ECE-445/smart-insole/notebooks/ramseyv2/4/9/aperture.png

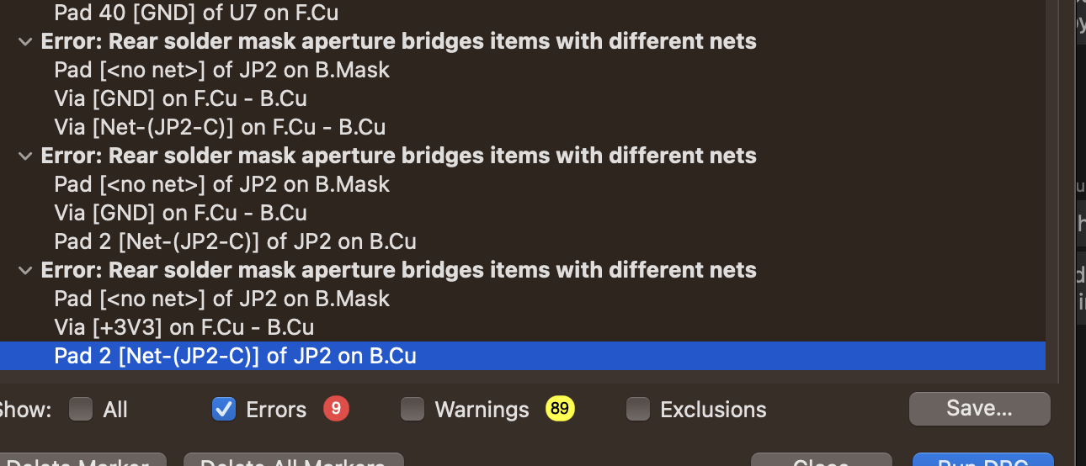
notebooks/ramseyv2/4/9/aperture.png
