ECE-445/smart-insole/notebooks/ramseyv2/software.png

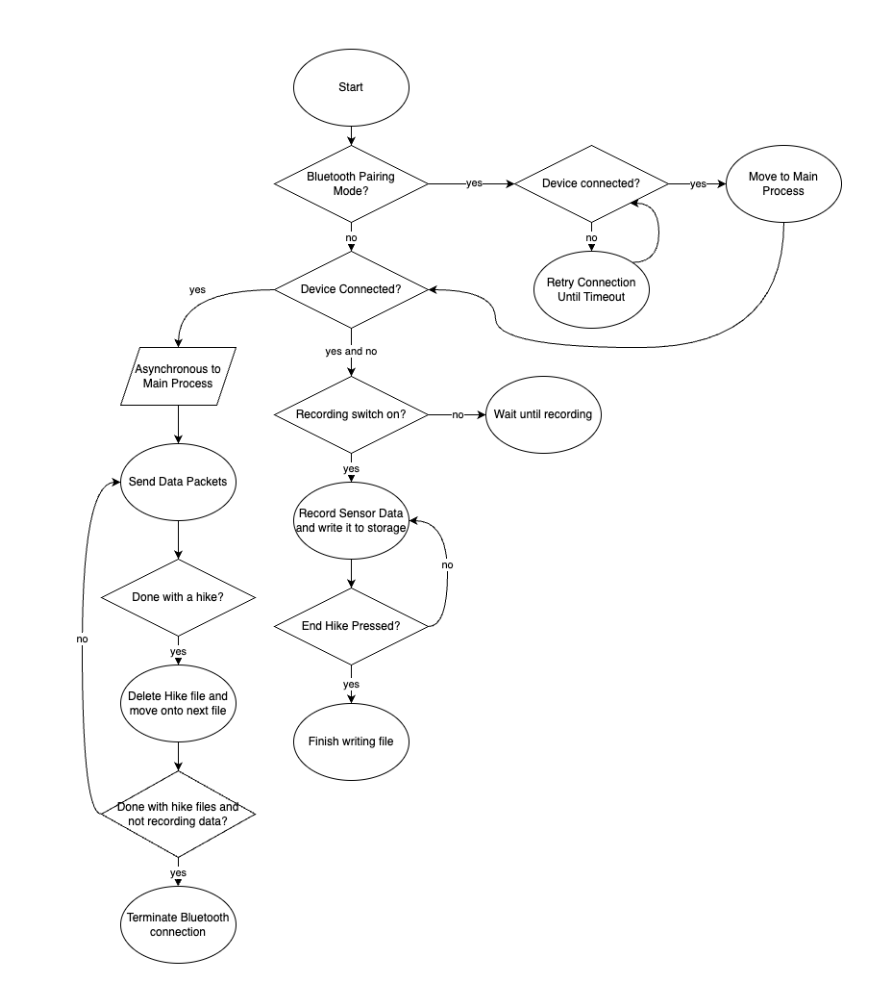
notebooks/ramseyv2/software.png
