ECE-445/smart-insole/boards/SmartInsolePCB/ESP32_S3_MINI_1_N8/ESP32-S3-MINI-1-N8.step

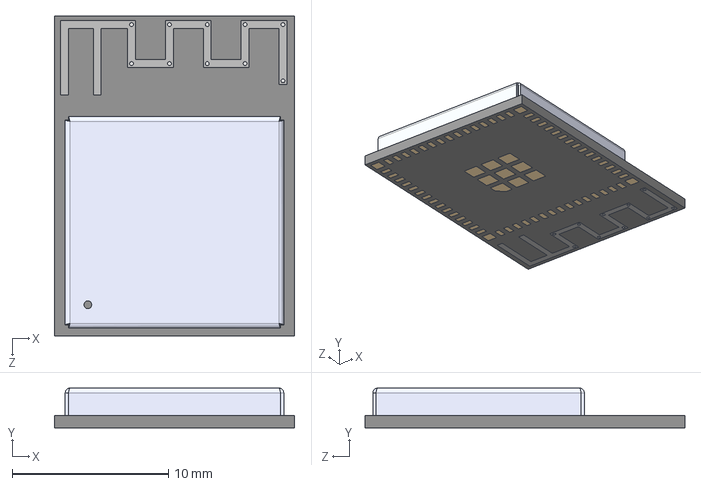
[picture p62: CAD file, 2024-02-29]
boards/SmartInsolePCB/ESP32_S3_MINI_1_N8/ESP32-S3-MINI-1-N8.step
15.4 x 2.55 x 20.5 mm
