ECE-445/smart-insole/boards/SmartInsolePCB/Footprints/ESP32-S3 footprint/ESP32-S3.step

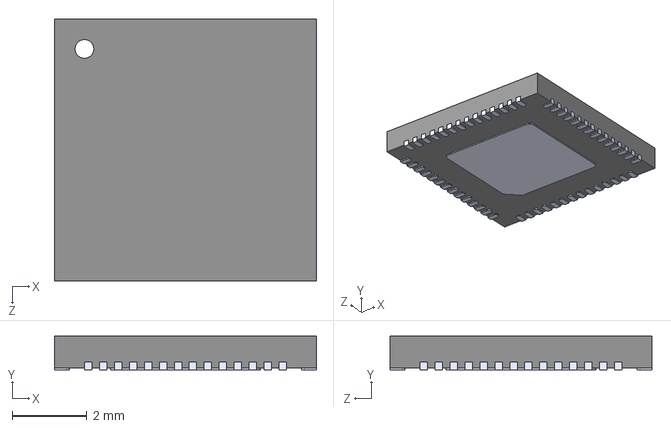
[picture p63: CAD file, 2024-03-01]
boards/SmartInsolePCB/Footprints/ESP32-S3 footprint/ESP32-S3.step
7.00 x 0.9 x 7.00 mm
