ECE-445/smart-insole/boards/SmartInsolePCB/Footprints/PJS008U-3000-0/PJS008U-3000-0/3D/PJS008U-3000-0.stp

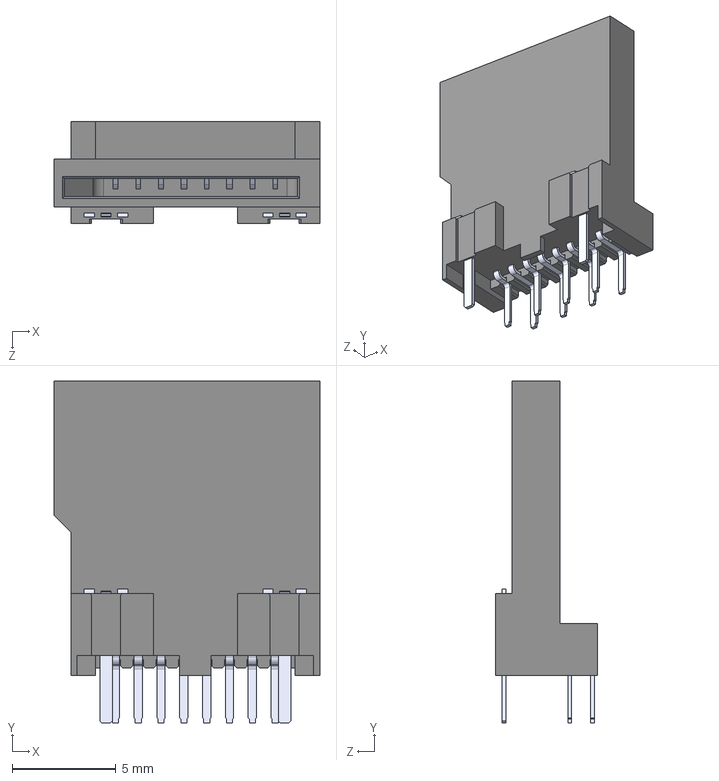
[picture p64: CAD file, 2024-03-05]
boards/SmartInsolePCB/Footprints/PJS008U-3000-0/PJS008U-3000-0/3D/PJS008U-3000-0.stp
12.8 x 16.5 x 4.90 mm
