ECE-445/smart-insole/boards/SmartInsolePCB/LIB_D3V3XA4B10LP-7/3D_MODEL_D3V3XA4B10LP-7.stp

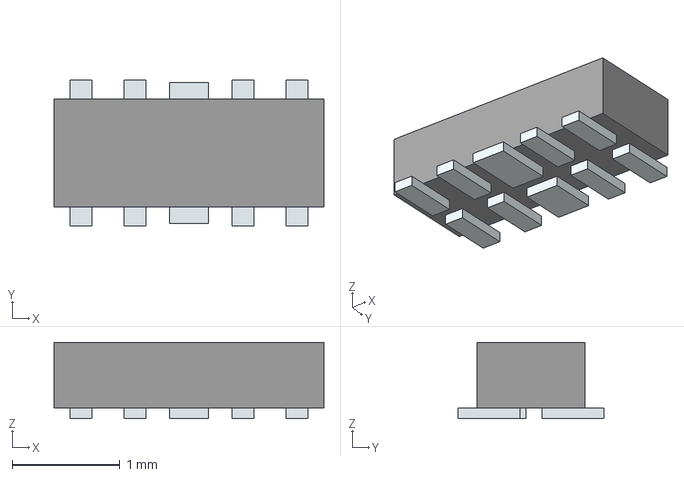
[picture p65: CAD file, 2024-02-29]
boards/SmartInsolePCB/LIB_D3V3XA4B10LP-7/3D_MODEL_D3V3XA4B10LP-7.stp
2.50 x 1.35 x 0.705 mm
Pins
