ECE-445/smart-insole/boards/SmartInsolePCB/PTS810SJK250SMTR LFS/PTS810SJK250SMTR LFS--3DModel-STEP-56544.STEP

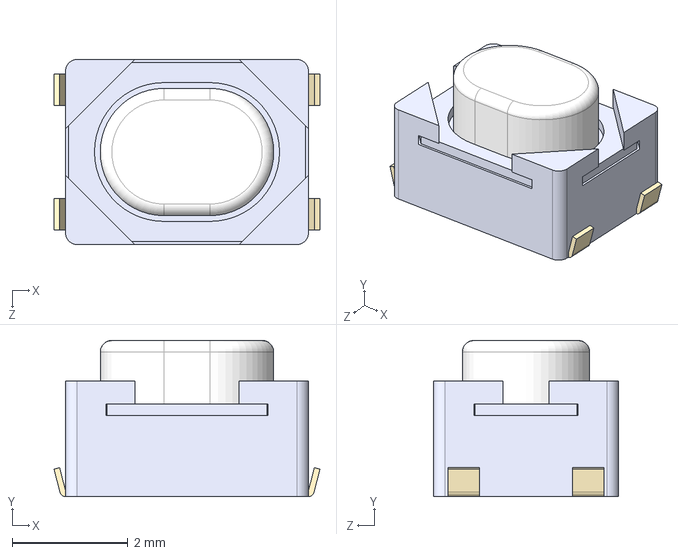
[picture p66: CAD file, 2024-02-29]
boards/SmartInsolePCB/PTS810SJK250SMTR LFS/PTS810SJK250SMTR LFS--3DModel-STEP-56544.STEP
4.60 x 2.70 x 3.20 mm
