ECE-445/smart-insole/boards/SmartInsoleV2/Footprints/MEM2051-00-195-00-A/MEM2051-00-195-00-A.step

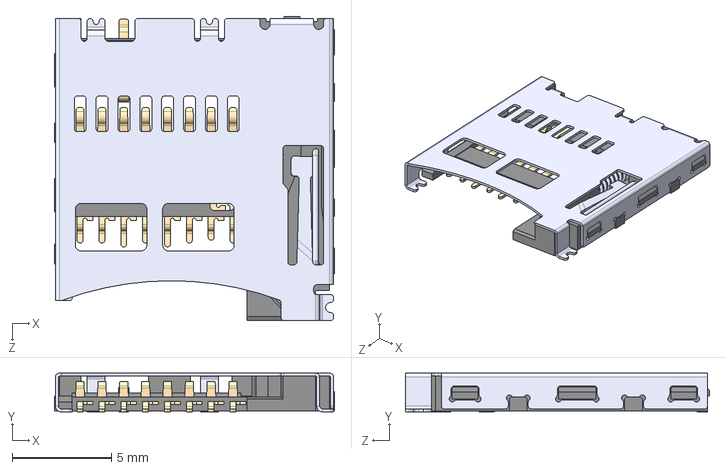
[picture p67: CAD file, 2024-04-05]
boards/SmartInsoleV2/Footprints/MEM2051-00-195-00-A/MEM2051-00-195-00-A.step
14.1 x 1.95 x 15.3 mm
