ECE-445/smart-insole/boards/SmartInsolePCB/Footprints/LIB 78800-0001/78800-0001/3D/78800-0001.stp

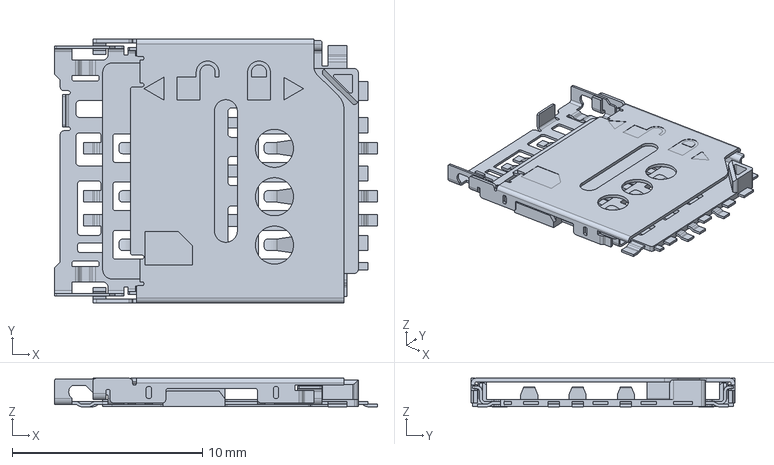
[picture p68: CAD file, 2024-03-05]
boards/SmartInsolePCB/Footprints/LIB 78800-0001/78800-0001/3D/78800-0001.stp
17.0 x 13.8 x 1.50 mm
