ECE-445/smart-insole/(list of files, cad)

Other CAD files:
boards/SmartInsolePCB/Footprints/LIB 78800-0001/78800-0001/Allegro/788000001.psm
boards/SmartInsolePCB/Footprints/LIB 78800-0001/78800-0001/DEHDL/78800_0001/chips/chips.prt
boards/SmartInsolePCB/Footprints/PJS008U-3000-0/PJS008U-3000-0/Allegro/pjs008u30000.psm
boards/SmartInsolePCB/Footprints/PJS008U-3000-0/PJS008U-3000-0/DEHDL/pjs008u_3000_0/chips/chips.prt
