ECE-445/smart-insole/(list of files, drawings)

Other design files:
boards/SmartInsolePCB/Footprints/LIB 78800-0001/78800-0001/Altium/78800-0001.SchLib
boards/SmartInsolePCB/Footprints/LIB 78800-0001/78800-0001/Altium/788000001.PcbLib
boards/SmartInsolePCB/Footprints/PJS008U-3000-0/PJS008U-3000-0/Altium/PJS008U30000.PcbLib
boards/SmartInsolePCB/Footprints/PJS008U-3000-0/PJS008U-3000-0/Altium/PJS008U-3000-0.SchLib
