ECE-445/smart-insole/boards/SmartInsoleV2/esp32_example.kicad_pcb

## KiCad design boards/SmartInsoleV2/esp32_example.kicad_pcb (2024-04-25)

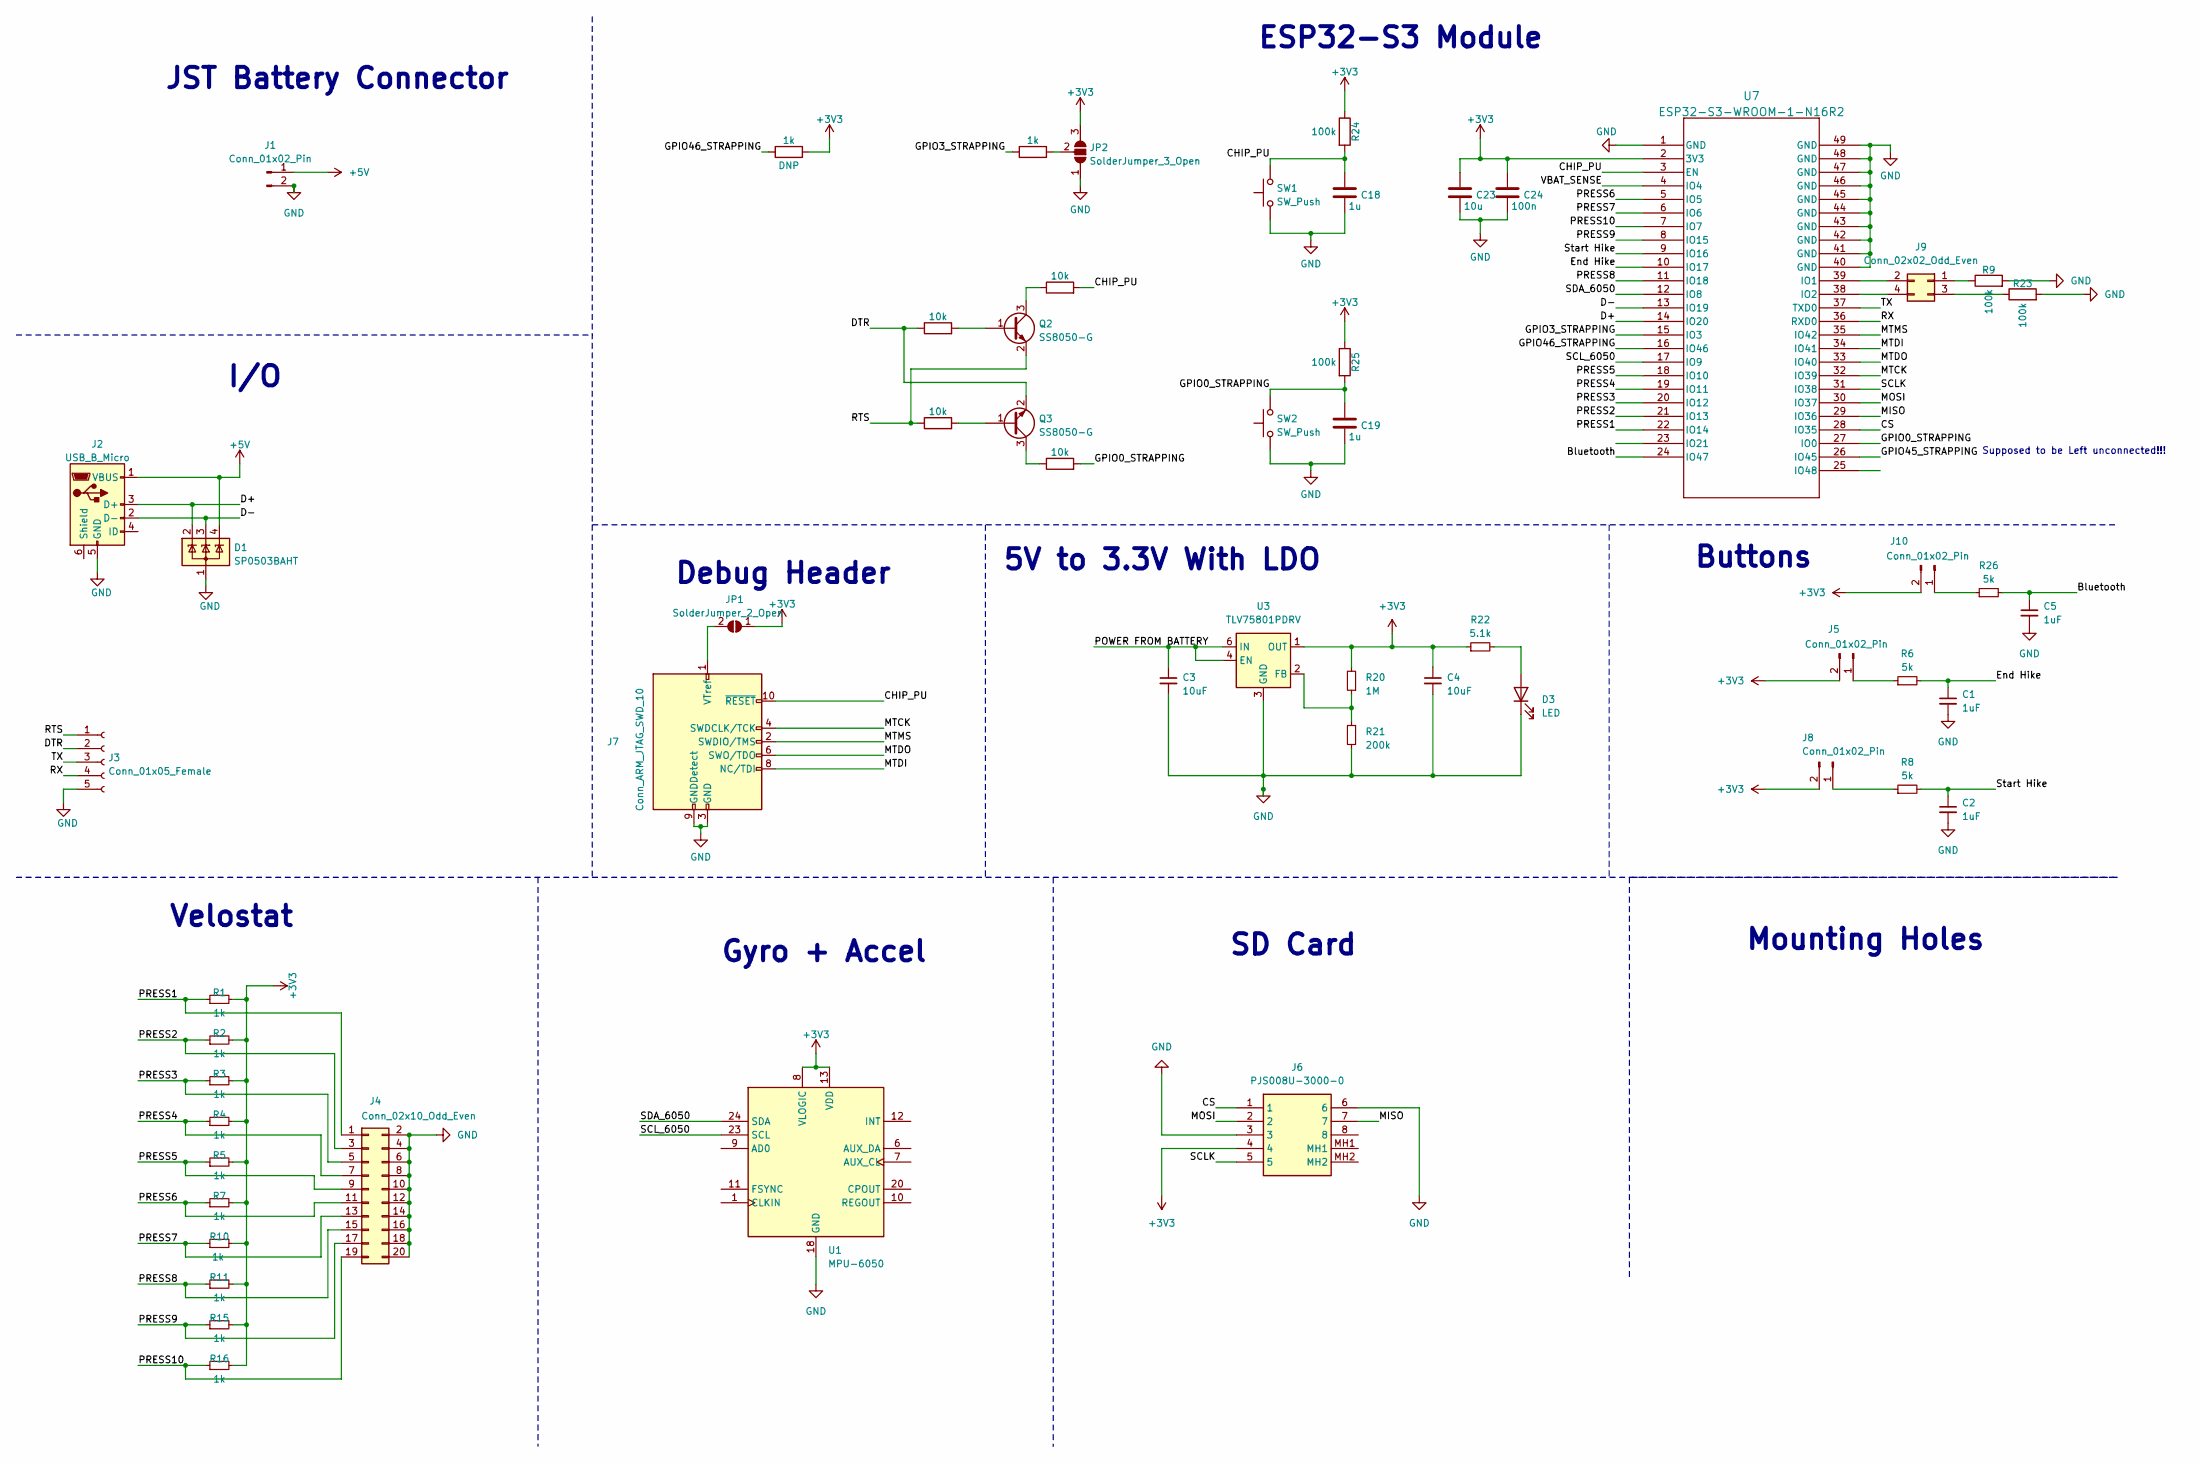
[picture p69: schematic esp32_example.kicad_sch, Smart Insole]

Parts:
C1, C2, C5: 1uF; C_0805_2012Metric
C3, C4: 10uF; C_0805_2012Metric
C18, C19: 1u; C_0805_2012Metric
C23: 10u; C_0805_2012Metric
C24: 100n; C_0805_2012Metric
D1: SP0503BAHT; SOT-143
D3: LED; LED_0805_2012Metric
J1: Conn_01x02_Pin; JST_PH_B2B-PH-K_1x02_P2.00mm_Vertical
J2: USB_B_Micro; USB_Micro-B_Amphenol_10118194_Horizontal
J3: Conn_01x05_Female; PinHeader_1x05_P2.54mm_Vertical
J4: Conn_02x10_Odd_Even; PinHeader_2x10_P2.54mm_Vertical
J5, J8, J10: Conn_01x02_Pin; PinHeader_1x02_P2.54mm_Vertical
J6: PJS008U-3000-0; GCT_MEM2051-00-195-00-A; Mouser Part Number 945-PJS008U-3000-0
J7: Conn_ARM_JTAG_SWD_10; IDC-Header_2x05_P2.54mm_Vertical
J9: Conn_02x02_Odd_Even; PinHeader_2x02_P2.54mm_Vertical
JP1: SolderJumper_2_Open; SolderJumper-2_P1.3mm_Open_TrianglePad1.0x1.5mm
JP2: SolderJumper_3_Open; SolderJumper-3_P2.0mm_Open_TrianglePad1.0x1.5mm
Q2, Q3: SS8050-G; SOT-23
R1, R2, R3, R4, R5, R7, R10, R11, R12, R15, R16, R17: 1k; R_0805_2012Metric
R6, R8, R26: 5k; R_0805_2012Metric
R9, R23, R24, R25: 100k; R_0805_2012Metric
R13, R14, R18, R19: 10k; R_0805_2012Metric
R20: 1M; R_0603_1608Metric
R21: 200k; R_0603_1608Metric
R22: 5.1k; R_0603_1608Metric
SW1, SW2: SW_Push; SW_SPST_B3S-1000
U1: MPU-6050; InvenSense_QFN-24_4x4mm_P0.5mm
U3: TLV75801PDRV; WSON-6-1EP_2x2mm_P0.65mm_EP1x1.6mm
U7: ESP32-S3-WROOM-1-N16R2; ESP32-S3-WROOM-1_EXP

Connections:
+3V3: C4.1, C23.1, C24.1, J5.2, J6.4, J8.2, J10.2, JP1.1 (A), JP2.3 (B), R1.2, R2.2, R3.2, R4.2, R5.2, R7.2, R10.2, R11.2, R12.2, R15.2, R16.2, R20.2, R22.1, R24.1, R25.1, U1.8 (VLOGIC), U1.13 (VDD), U3.1 (OUT), U7.2 (3V3)
+5V: D1.4 (K), J1.1, J2.1 (VBUS)
/Bluetooth: C5.1, R26.2, U7.24 (IO47)
/CHIP_PU: C18.1, J7.10 (~RESET), R18.2, R24.2, SW1.2, U7.3 (EN)
/CS: J6.1, U7.28 (IO35)
/D+: D1.2 (K), J2.3 (D+), U7.14 (IO20)
/D-: D1.3 (K), J2.2 (D-), U7.13 (IO19)
/DTR: J3.2, Q3.2 (E), R13.1
/End Hike: C1.1, R6.2, U7.10 (IO17)
/GPIO0_STRAPPING: C19.1, R19.2, R25.2, SW2.2, U7.27 (IO0)
/GPIO3_STRAPPING: R17.1, U7.15 (IO3)
/GPIO45_STRAPPING: U7.26 (IO45)
/GPIO46_STRAPPING: R12.1, U7.16 (IO46)
/MISO: J6.7, U7.29 (IO36)
/MOSI: J6.2, U7.30 (IO37)
/MTCK: J7.4 (SWDCLK/TCK), U7.32 (IO39)
/MTDI: J7.8 (NC/TDI), U7.34 (IO41)
/MTDO: J7.6 (SWO/TDO), U7.33 (IO40)
/MTMS: J7.2 (SWDIO/TMS), U7.35 (IO42)
/POWER FROM BATTERY: C3.1, U3.4 (EN), U3.6 (IN)
/PRESS1: J4.1, R1.1, U7.22 (IO14)
/PRESS2: J4.3, R2.1, U7.21 (IO13)
/PRESS3: J4.5, R3.1, U7.20 (IO12)
/PRESS4: J4.7, R4.1, U7.19 (IO11)
/PRESS5: J4.9, R5.1, U7.18 (IO10)
/PRESS6: J4.11, R7.1, U7.5 (IO5)
/PRESS7: J4.13, R10.1, U7.6 (IO6)
/PRESS8: J4.15, R11.1, U7.11 (IO18)
/PRESS9: J4.17, R15.1, U7.8 (IO15)
/PRESS10: J4.19, R16.1, U7.7 (IO7)
/RTS: J3.1, Q2.2 (E), R14.1
/RX: J3.4, U7.36 (RXD0)
/SCLK: J6.5, U7.31 (IO38)
/SCL_6050: U1.23 (SCL), U7.17 (IO9)
/SDA_6050: U1.24 (SDA), U7.12 (IO8)
/Start Hike: C2.1, R8.2, U7.9 (IO16)
/TX: J3.3, U7.37 (TXD0)
/VBAT_SENSE: U7.4 (IO4)
GND: C1.2, C2.2, C3.2, C4.2, C5.2, C18.2, C19.2, C23.2, C24.2, D1.1 (A), D3.1 (K), J1.2, J2.5 (GND), J3.5, J4.2, J4.4, J4.6, J4.8, J4.10, J4.12, J4.14, J4.16, J4.18, J4.20, J6.3, J6.6, J7.3 (GND), J7.5 (GND), J7.9 (GNDDetect), JP2.1 (A), R9.2, R21.1, R23.2, SW1.1, SW2.1, U1.18 (GND), U3.3 (GND), U3.7 (GND), U7.1 (GND), U7.40 (GND), U7.41 (GND), U7.42 (GND), U7.43 (GND), U7.44 (GND), U7.45 (GND), U7.46 (GND), U7.47 (GND), U7.48 (GND), U7.49 (GND)
unnamed: D3.2 (A), R22.2
unnamed: J5.1, R6.1
unnamed: J7.1 (VTref), JP1.2 (B)
unnamed: J8.1, R8.1
unnamed: J9.1, R9.1
unnamed: J9.2, U7.39 (IO1)
unnamed: J9.3, R23.1
unnamed: J9.4, U7.38 (IO2)
unnamed: J10.1, R26.1
unnamed: JP2.2 (C), R17.2
unnamed: Q2.1 (B), R13.2
unnamed: Q2.3 (C), R18.1
unnamed: Q3.1 (B), R14.2
unnamed: Q3.3 (C), R19.1
unnamed: R20.1, R21.2, U3.2 (FB)

Notes on the sheet:
JST Battery Connector
Buttons
SD Card
Velostat
ESP32-S3 Module
Gyro + Accel
Debug Header
Supposed to be Left unconnected!!!
Mounting Holes
5V to 3.3V With LDO
I/O

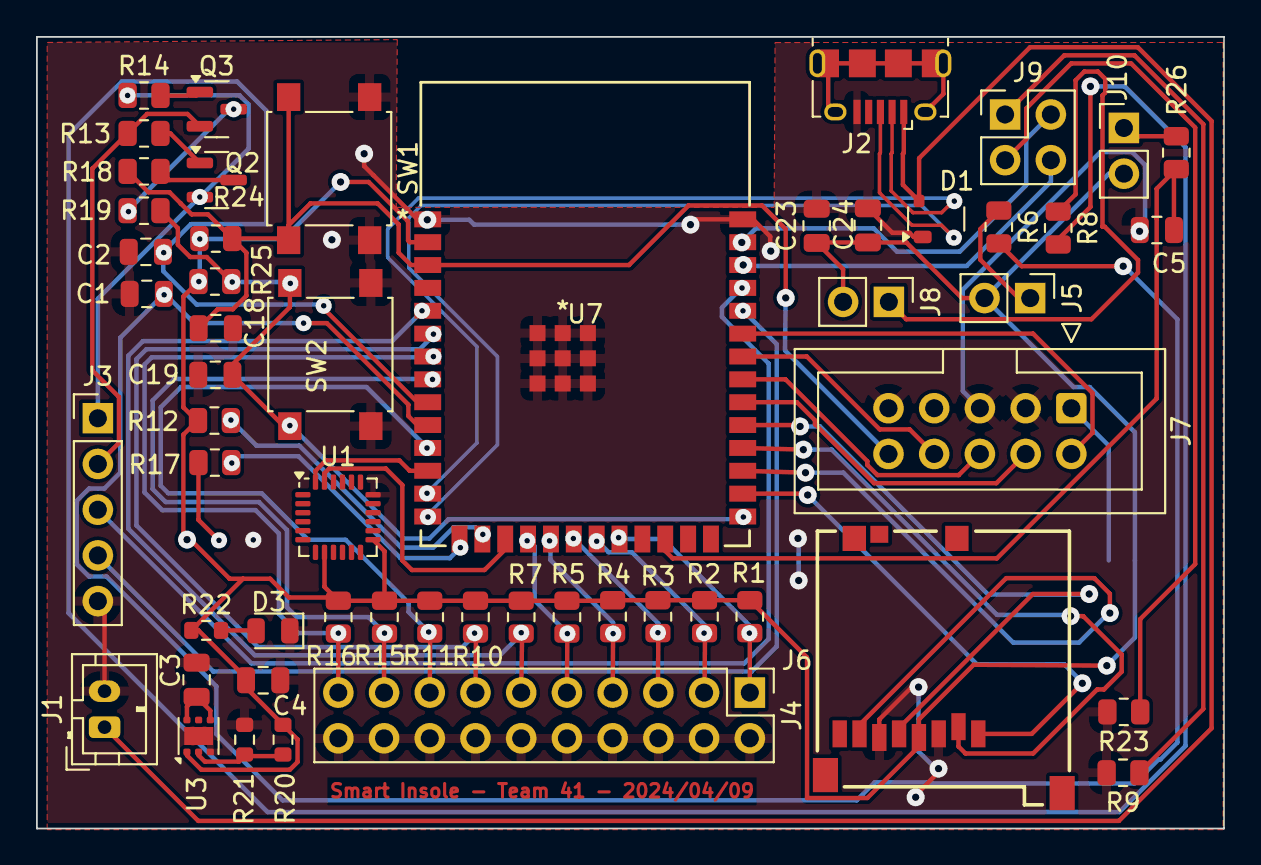
[picture p70: board esp32_example.kicad_pcb from above]

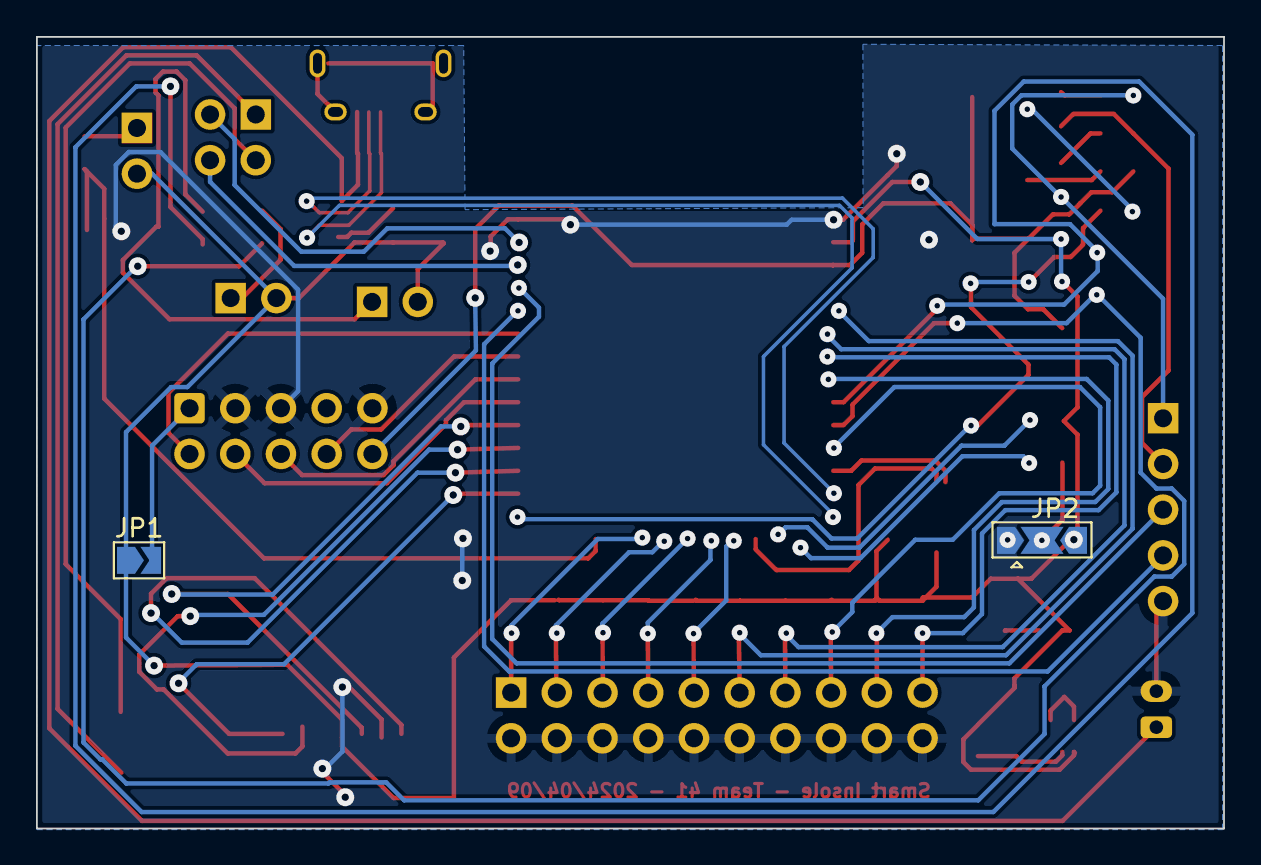
[picture p71: board esp32_example.kicad_pcb from below]

Board: 2 copper layers, 65.9 x 44.0 mm, 56 parts (2 on the bottom side), 52 nets.
