ECE-445/smart-insole/boards/SmartInsolePCB/DesignESP32PCB.kicad_pcb

## KiCad design boards/SmartInsolePCB/DesignESP32PCB.kicad_pcb (2024-03-19)

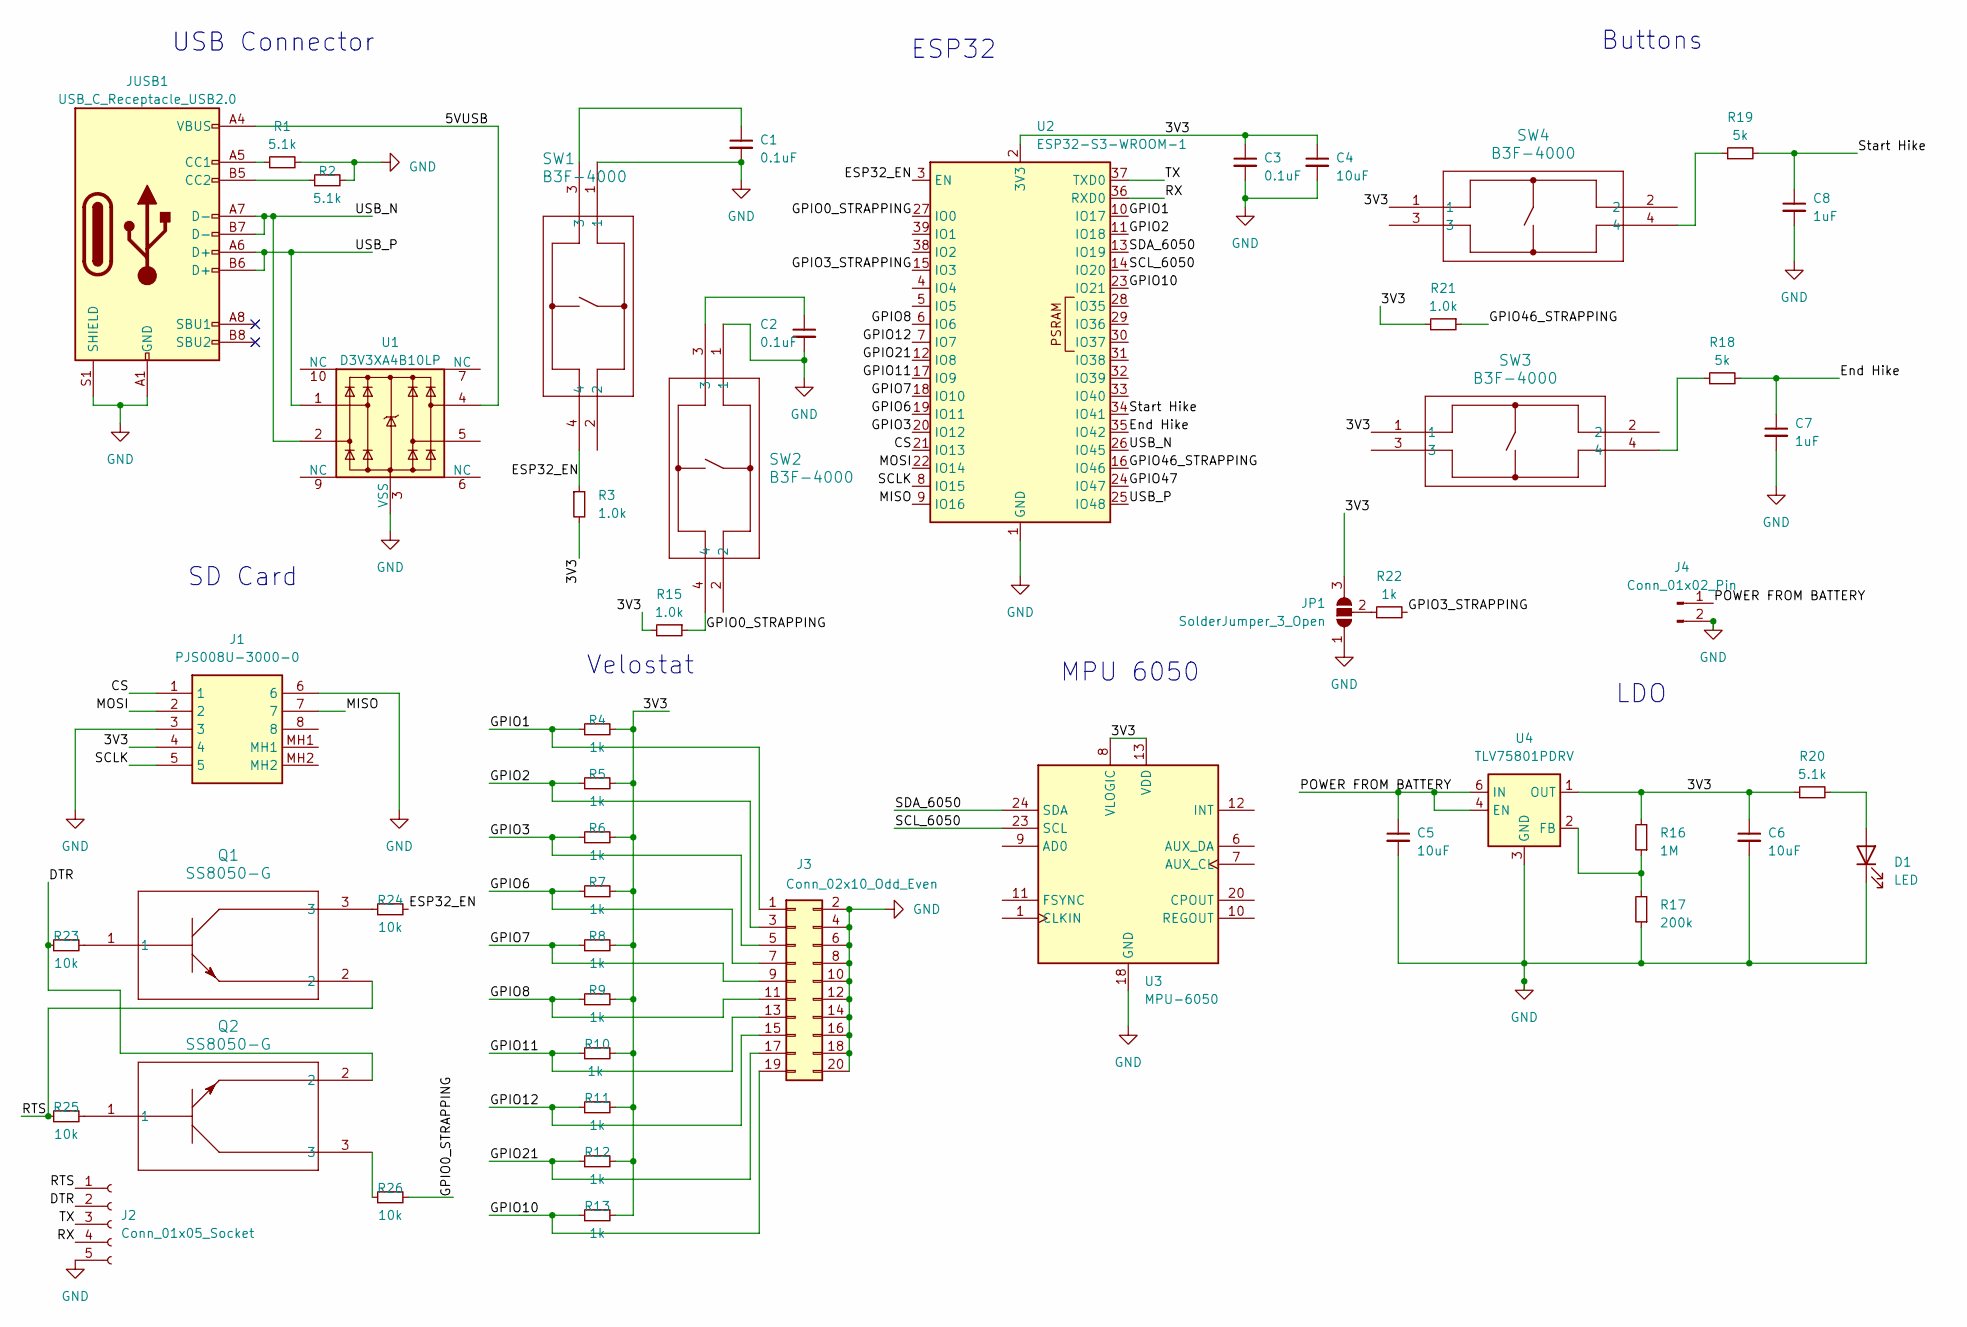
[picture p72: schematic DesignESP32PCB.kicad_sch, Smart Insole PCB Design]

Parts:
C1, C2, C3: 0.1uF; C_0603_1608Metric
C4, C5, C6: 10uF; C_0603_1608Metric
C7, C8: 1uF; C_0603_1608Metric
D1: LED; LED_0603_1608Metric
J1: PJS008U-3000-0; PJS008U30000; Mouser Part Number 945-PJS008U-3000-0
J2: Conn_01x05_Socket; PinHeader_1x05_P2.54mm_Vertical
J3: Conn_02x10_Odd_Even; PinHeader_2x10_P2.54mm_Vertical
J4: Conn_01x02_Pin; JST_PH_B2B-PH-K_1x02_P2.00mm_Vertical
JP1: SolderJumper_3_Open; SolderJumper-3_P1.3mm_Open_RoundedPad1.0x1.5mm
JUSB1: USB_C_Receptacle_USB2.0; USB_C_Receptacle_GCT_USB4105-xx-A_16P_TopMnt_Horizontal
Q1, Q2: SS8050-G; TRAN_SS8050-G_CIP
R1, R2, R20: 5.1k; R_0603_1608Metric
R3, R15, R21: 1.0k; R_0603_1608Metric
R4, R5, R6, R7, R8, R9, R10, R11, R12, R13, R22: 1k; R_0603_1608Metric
R16: 1M; R_0603_1608Metric
R17: 200k; R_0603_1608Metric
R18, R19: 5k; R_0603_1608Metric
R23, R24, R25, R26: 10k; R_0603_1608Metric
SW1, SW2, SW3, SW4: B3F-4000; SW_B3F-4000_OMR
U1: D3V3XA4B10LP; Diodes_UDFN-10_1.0x2.5mm_P0.5mm
U2: ESP32-S3-WROOM-1
U3: MPU-6050; InvenSense_QFN-24_4x4mm_P0.5mm
U4: TLV75801PDRV; WSON-6-1EP_2x2mm_P0.65mm_EP1x1.6mm

Connections:
/3V3: C3.1, C4.1, C6.1, J1.4, JP1.3 (B), R3.2, R4.2, R5.2, R6.2, R7.2, R8.2, R9.2, R10.2, R11.2, R12.2, R13.2, R15.2, R16.2, R20.1, R21.2, SW3.1, SW4.1, U2.2 (3V3), U3.8 (VLOGIC), U3.13 (VDD), U4.1 (OUT)
/5VUSB: JUSB1.A4 (VBUS), JUSB1.A9 (VBUS), JUSB1.B4 (VBUS), JUSB1.B9 (VBUS), U1.4
/CS: J1.1, U2.21 (IO13)
/DTR: J2.2, Q2.2, R23.1
/ESP32_EN: R3.1, R24.2, SW1.4, U2.3 (EN)
/End Hike: C7.1, R18.2, U2.35 (IO42)
/GPIO0_STRAPPING: R15.1, R26.2, SW2.4, U2.27 (IO0)
/GPIO1: J3.1, R4.1, U2.10 (IO17)
/GPIO2: J3.3, R5.1, U2.11 (IO18)
/GPIO3: J3.5, R6.1, U2.20 (IO12)
/GPIO3_STRAPPING: R22.2, U2.15 (IO3)
/GPIO6: J3.7, R7.1, U2.19 (IO11)
/GPIO7: J3.9, R8.1, U2.18 (IO10)
/GPIO8: J3.11, R9.1, U2.6 (IO6)
/GPIO10: J3.19, R13.1, U2.23 (IO21)
/GPIO11: J3.13, R10.1, U2.17 (IO9)
/GPIO12: J3.15, R11.1, U2.7 (IO7)
/GPIO21: J3.17, R12.1, U2.12 (IO8)
/GPIO46_STRAPPING: R21.1, U2.16 (IO46)
/GPIO47: U2.24 (IO47)
/MISO: J1.7, U2.9 (IO16)
/MOSI: J1.2, U2.22 (IO14)
/POWER FROM BATTERY: C5.1, J4.1, U4.4 (EN), U4.6 (IN)
/RTS: J2.1, Q1.2, R25.1
/RX: J2.4, U2.36 (RXD0)
/SCLK: J1.5, U2.8 (IO15)
/SCL_6050: U2.14 (IO20), U3.23 (SCL)
/SDA_6050: U2.13 (IO19), U3.24 (SDA)
/Start Hike: C8.1, R19.2, U2.34 (IO41)
/TX: J2.3, U2.37 (TXD0)
/USB_N: JUSB1.A7 (D-), JUSB1.B7 (D-), U1.2, U2.26 (IO45)
/USB_P: JUSB1.A6 (D+), JUSB1.B6 (D+), U1.1, U2.25 (IO48)
GND: C1.2, C2.2, C3.2, C4.2, C5.2, C6.2, C7.2, C8.2, D1.1 (K), J1.3, J1.6, J2.5, J3.2, J3.4, J3.6, J3.8, J3.10, J3.12, J3.14, J3.16, J3.18, J3.20, J4.2, JP1.1 (A), JUSB1.A1 (GND), JUSB1.A12 (GND), JUSB1.B1 (GND), JUSB1.B12 (GND), JUSB1.S1 (SHIELD), R1.2, R2.2, R17.1, SW1.1, SW2.1, U1.3 (VSS), U1.8 (VSS), U2.1 (GND), U2.40 (GND), U2.41 (GND), U3.18 (GND), U4.3 (GND), U4.7 (GND)
unnamed: C1.1, SW1.3
unnamed: C2.1, SW2.3
unnamed: D1.2 (A), R20.2
unnamed: JP1.2 (C), R22.1
unnamed: JUSB1.A5 (CC1), R1.1
unnamed: JUSB1.B5 (CC2), R2.1
unnamed: Q1.1, R23.2
unnamed: Q1.3, R24.1
unnamed: Q2.1, R25.2
unnamed: Q2.3, R26.1
unnamed: R18.1, SW3.4
unnamed: R19.1, SW4.4
unnamed: R16.1, R17.2, U4.2 (FB)

Notes on the sheet:
MPU 6050
ESP32
SD Card
USB Connector
LDO
Buttons
Velostat

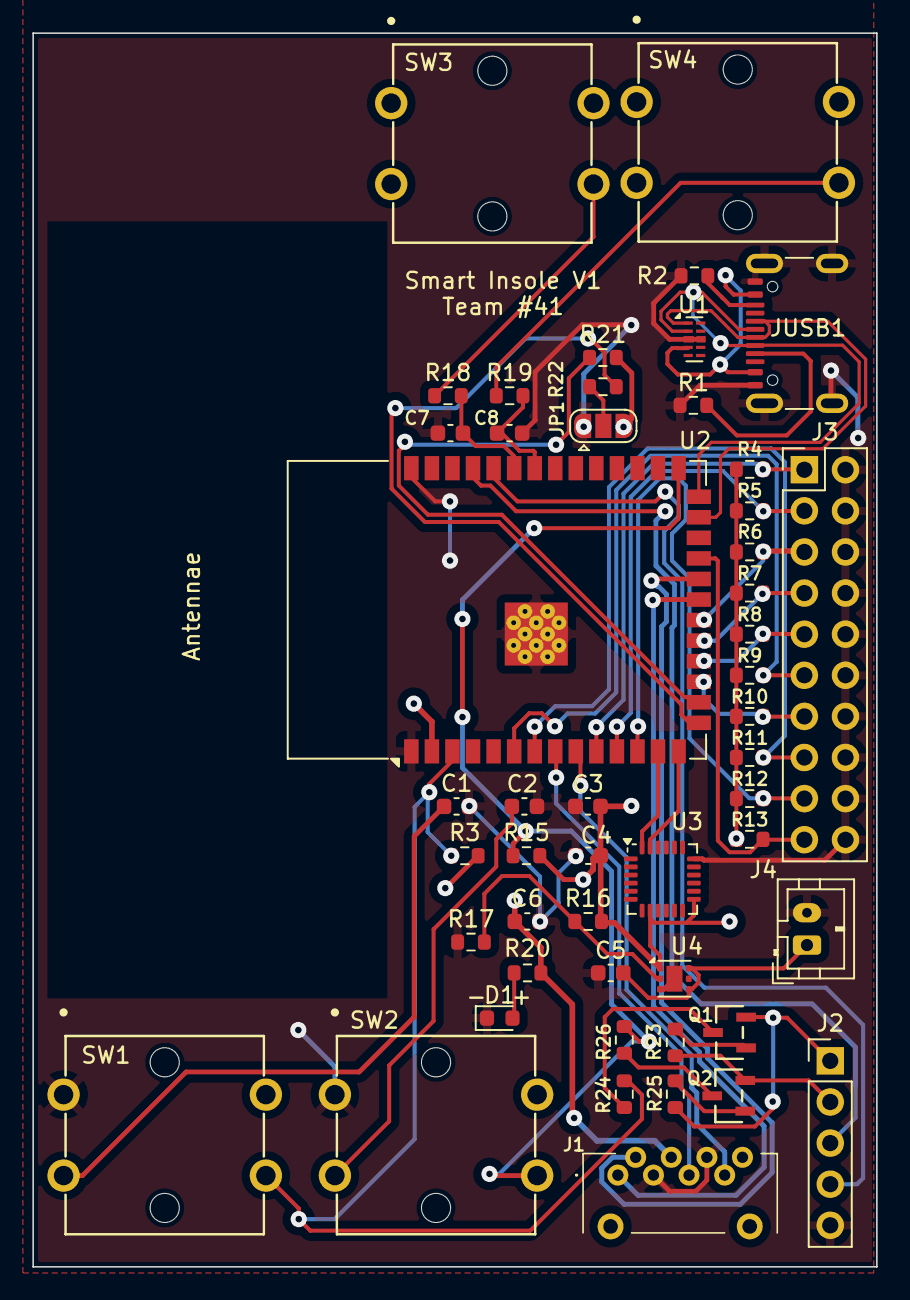
[picture p73: board DesignESP32PCB.kicad_pcb from above]

Board: 2 copper layers, 52.1 x 76.2 mm, 50 parts (0 on the bottom side), 45 nets.
