ECE-445/smart-insole/(commit log)

2024-02-29 Project With basic layout
    [3D_MODEL_D3V3XA4B10LP-7.stp, DesignESP32PCB.kicad_sch, ESP32-S3-MINI-1-N8.step, PTS810SJK250SMTR LFS--3DModel-STEP-56544.STEP]
2024-03-01 added 6050, added footprints
    [DesignESP32PCB.kicad_sch, ESP32-S3.step]
2024-03-01 added SD card Pin headers
    [DesignESP32PCB.kicad_sch]
2024-03-01 replaced ESP32 symbol
    [DesignESP32PCB.kicad_sch]
2024-03-01 PCB design
    [DesignESP32PCB.kicad_pcb]
2024-03-04 debounced buttons and connected pins
    [DesignESP32PCB.kicad_sch]
2024-03-05 finished schematic
    [78800-0001.SchLib, 78800-0001.stp, 788000001.PcbLib, 788000001.psm, DesignESP32PCB.kicad_pcb, DesignESP32PCB.kicad_sch, EDI2CAP.CFG, PJS008U-3000-0.SchLib]
2024-03-05 finished all PCB connections
    [DesignESP32PCB.kicad_pcb, DesignESP32PCB.kicad_sch]
2024-03-05 finished PCB second push just in case
2024-03-05 changed GPIO
    [DesignESP32PCB.kicad_sch]
2024-03-05 down from 200 to 43 errors
    [DesignESP32PCB.kicad_pcb]
2024-03-06 schematic and pcb updates
    [DesignESP32PCB.kicad_pcb, DesignESP32PCB.kicad_sch]
2024-03-18 put extra comp on board
    [DesignESP32PCB.kicad_pcb]
2024-03-18 down to 56
    [DesignESP32PCB.kicad_pcb]
2024-03-18 2 missing connections and 16 erros
    [DesignESP32PCB.kicad_pcb]
2024-03-19 saved work
    [DesignESP32PCB.kicad_pcb]
2024-03-19 added footprint
    [DesignESP32PCB.kicad_sch]
2024-03-19 routed all connections
    [DesignESP32PCB.kicad_pcb, DesignESP32PCB.kicad_sch]
2024-03-19 Passed checks and gerber file created
    [DesignESP32PCB-B_Cu.gbl, DesignESP32PCB-B_Mask.gbs, DesignESP32PCB-B_Paste.gbp, DesignESP32PCB-B_Silkscreen.gbo, DesignESP32PCB-Edge_Cuts.gm1, DesignESP32PCB-F_Cu.gtl, DesignESP32PCB-F_Mask.gts, DesignESP32PCB-F_Paste.gtp]
2024-03-19 quick changes
    [DesignESP32PCB.kicad_pcb]
2024-03-31 added initial heatmap
2024-04-01 updated heatmap
2024-04-04 board V2
    [esp32_example-B_Cu.gbl, esp32_example-B_Mask.gbs, esp32_example-B_Paste.gbp, esp32_example-B_Silkscreen.gbo, esp32_example-Edge_Cuts.gm1, esp32_example-F_Cu.gtl, esp32_example-F_Mask.gts, esp32_example-F_Paste.gtp]
2024-04-04 a little progress
    [esp32_example.kicad_pcb]
2024-04-05 Most of routing done
    [MEM2051-00-195-00-A.step, esp32_example.kicad_pcb, esp32_example.kicad_sch]
2024-04-06 added changes but not finished
    [esp32_example.kicad_pcb, esp32_example.kicad_sch]
2024-04-09 re made board
    [esp32_example.kicad_pcb, esp32_example.kicad_sch]
2024-04-09 7 fine errors but need to double check the SD card footprint
    [esp32_example.kicad_pcb, esp32_example.kicad_sch]
2024-04-09 all errors checked including place from schematic
2024-04-10 submitted for round 5
    [DesignESP32PCB-B_Cu.gbl, DesignESP32PCB-B_Mask.gbs, DesignESP32PCB-B_Silkscreen.gbo, DesignESP32PCB-F_Cu.gtl, DesignESP32PCB-F_Mask.gts, DesignESP32PCB-F_Paste.gtp, DesignESP32PCB-F_Silkscreen.gto, DesignESP32PCB-NPTH.drl]
2024-04-10 added dimensions
    [esp32_example.kicad_pcb]
2024-04-25 Dimensions on PCB + notebook update
    [esp32_example.kicad_pcb]
