ECE-445/smart-insole/notebooks/ramseyv2/pcb_images/resin_print_top.jpeg

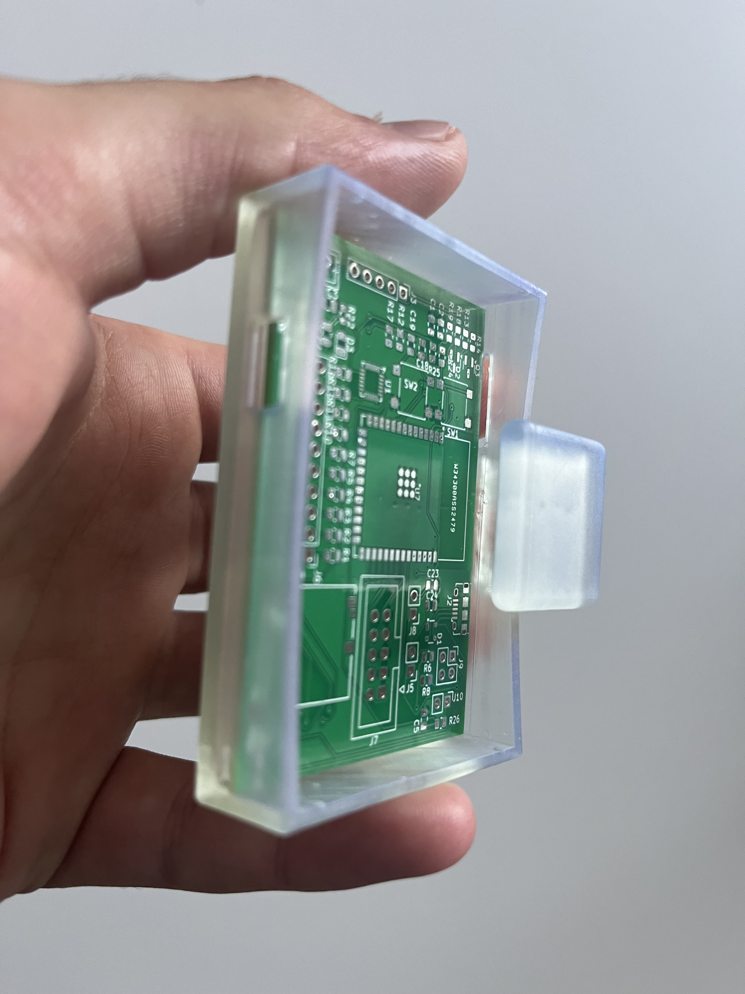
[picture p45: notebooks/ramseyv2/pcb_images/resin_print_top.jpeg]
notebooks/ramseyv2/pcb_images/resin_print_top.jpeg
