ECE-445/smart-insole/notebooks/ramseyv2/pcb_images/Resin_print_new.jpeg

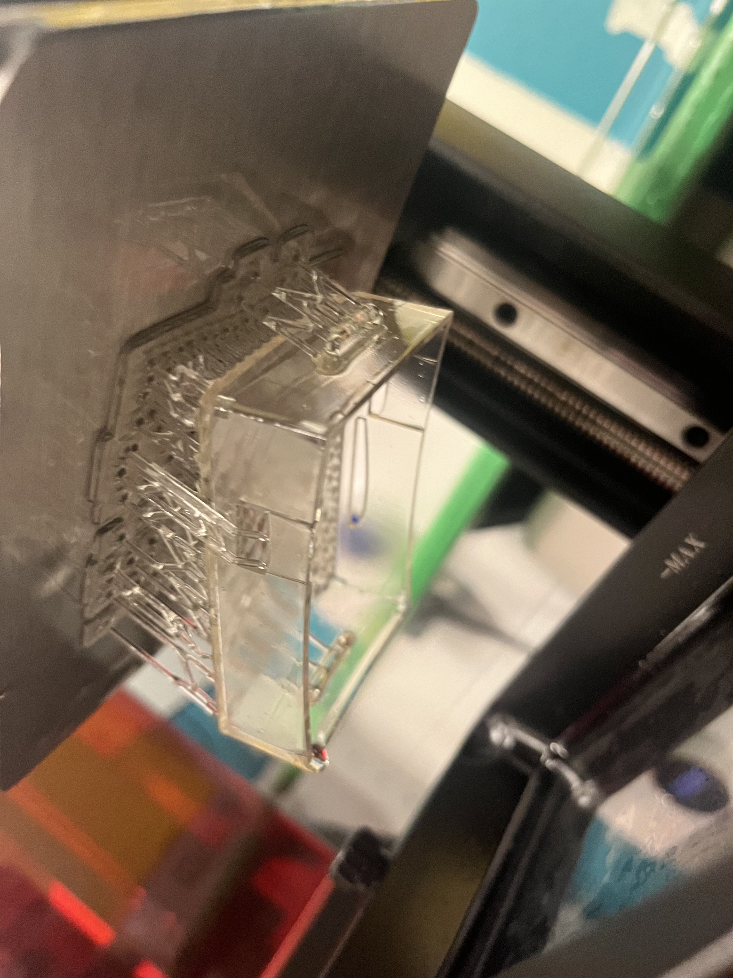
[picture p46: notebooks/ramseyv2/pcb_images/Resin_print_new.jpeg]
notebooks/ramseyv2/pcb_images/Resin_print_new.jpeg
