ECE-445/smart-insole/notebooks/ramseyv2/pcb_images/up_2_mm.jpeg

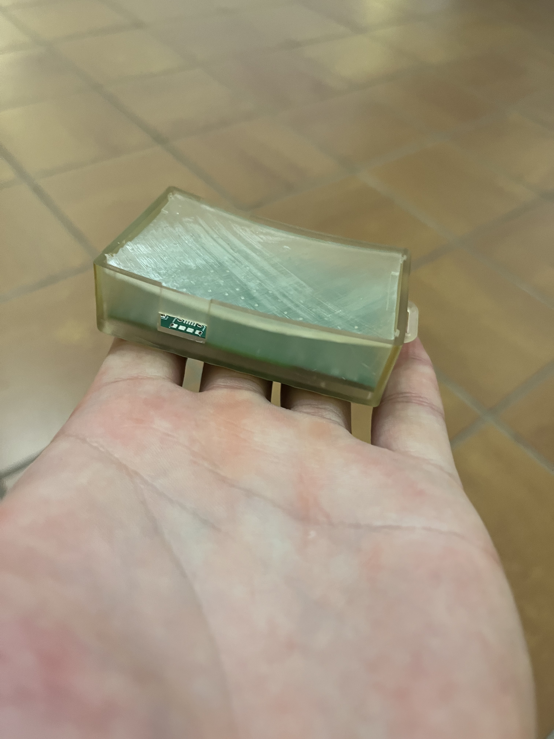
[picture p47: notebooks/ramseyv2/pcb_images/up_2_mm.jpeg]
notebooks/ramseyv2/pcb_images/up_2_mm.jpeg
