ECE-445/smart-insole/notebooks/ramseyv2/pcb_images/IMG_0492.jpeg

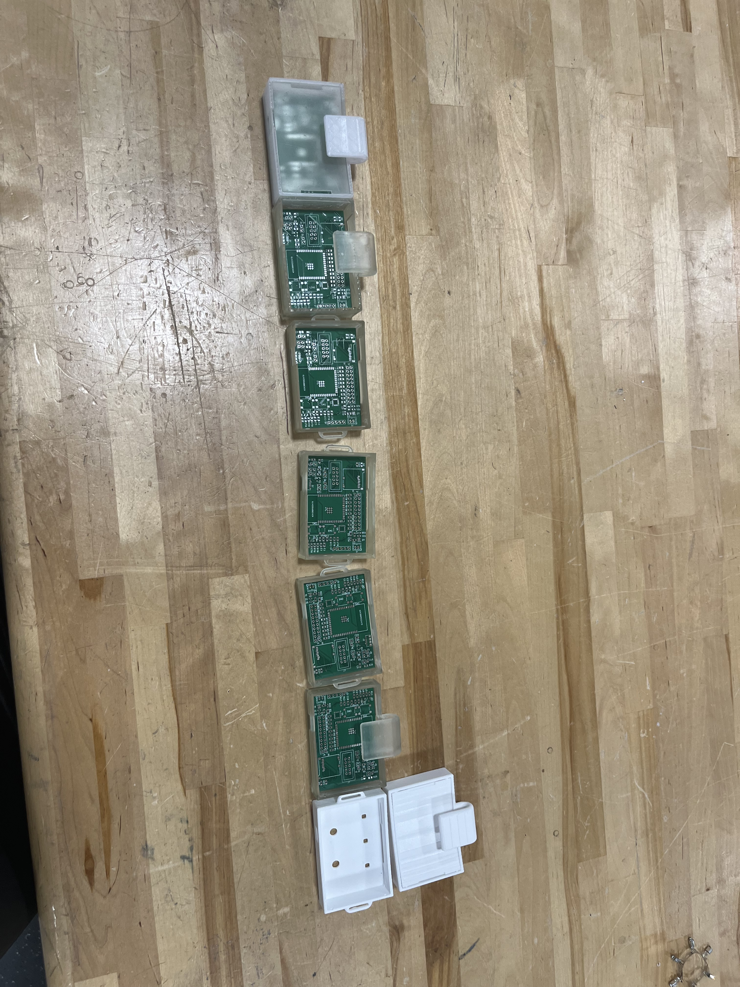
notebooks/ramseyv2/pcb_images/IMG_0492.jpeg
