ECE-445/smart-insole/notebooks/ramseyv2/pcb_images/Pre_oven.jpeg

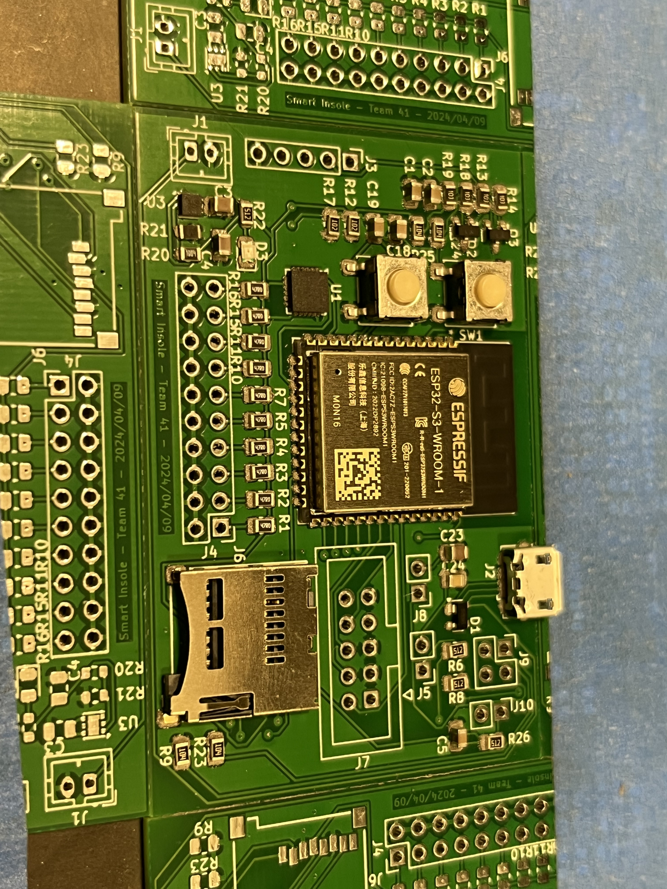
notebooks/ramseyv2/pcb_images/Pre_oven.jpeg
